kylechong7/Project-Lux/README.md

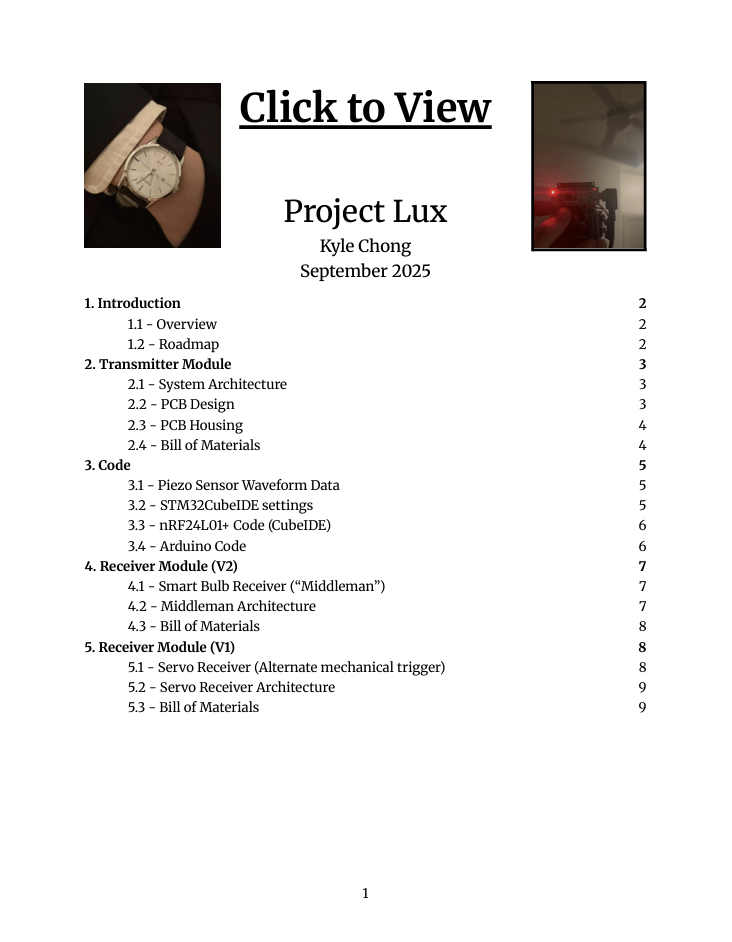
[picture p1: A_Overview/Click-to-view.png]
Open my site
