kylechong7/Project-Lux/A_Overview/cover-only.png

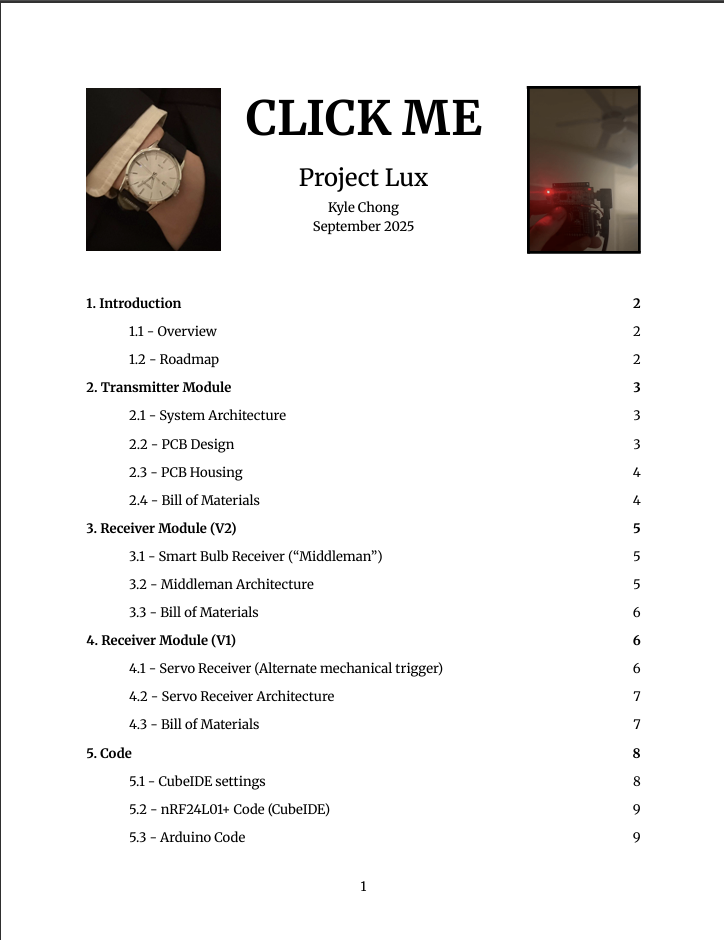
A_Overview/cover-only.png
