kylechong7/Project-Lux/PCB/CSV/bom.csv

Reference | Qty | Value | DNP | Exclude from BOM | Exclude from Board | Footprint | Datasheet
1k1,1M1,10k1 | 3 | R |  |  |  | Resistor_SMD:R_0603_1608Metric | ~
1uF1,100nF1,100nF2,100pF1 | 4 | C |  |  |  | Capacitor_SMD:C_0603_1608Metric | ~
4.7uF1 | 1 | C |  |  |  | Capacitor_SMD:C_0805_2012Metric | ~
D1 | 1 | LED |  |  |  | LED_SMD:LED_0603_1608Metric | ~
J3 | 1 | Piezo_Conn_Pin |  |  |  | Connector_Wire:SolderWire-0.15sqmm_1x04_P4mm_D0.5mm_OD1.5mm_Relief | ~
J4 | 1 | TC2070_-_Labelled |  | Excluded from BOM |  | TC2070:CONNECTOR_V1 | https://www.tag-connect.com/wp-content/uploads/bsk-pdf-manager/TC2070-IDC-NL_Datasheet_12.pdf
U1 | 1 | STM32G031K6Tx |  |  |  | Package_QFP:LQFP-32_7x7mm_P0.8mm | https://www.st.com/resource/en/datasheet/stm32g031k6.pdf
U3 | 1 | E01-ML01S |  |  |  | PCBLIB_E01-ML01S_2025-07-08:E01-ML01S
