kylechong7/Project-Lux/PCB/KiCad/Watch_PCB.kicad_pcb

## KiCad design PCB/KiCad/Watch_PCB.kicad_pcb (2025-10-12)

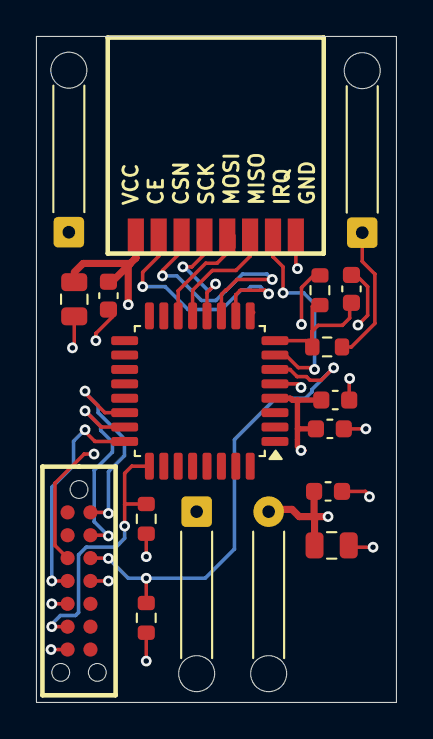
[picture p23: board Watch_PCB.kicad_pcb from above]

Board: 4 copper layers, 20.0 x 37.0 mm, 17 parts (0 on the bottom side), 14 nets.

Parts:
1M1, 10k1, 10k2, 10k3: R; R_0603_1608Metric
1uF1, 4.7nF1, 100nF1, 100nF2, 100nF3: C; C_0603_1608Metric
4.7uF1, 22uF1: C; C_0805_2012Metric
J1: Conn_01x02_Pin; SolderWire-0.15sqmm_1x02_P4mm_D0.5mm_OD1.5mm_Relief
J2, J3: Conn_01x01_Pin; SolderWire-0.15sqmm_1x01_D0.5mm_OD1.5mm_Relief
J4: TC2070_-_Labelled; CONNECTOR_V1
U1: STM32G031K6Tx; LQFP-32_7x7mm_P0.8mm
U3: E01-ML01S

Connections:
+3.3V: 1uF1.2, 4.7uF1.2, 10k2.1, 22uF1.2, 100nF1.2, 100nF2.1, 100nF3.1, J1.2, J4.3 (T_VCC), U1.4 (VDD), U3.1 (VCC)
GND: 1M1.2, 1uF1.1, 4.7nF1.2, 4.7uF1.1, 10k3.1, 10k3.2, 22uF1.1, 100nF1.1, 100nF2.2, 100nF3.2, J1.1, J3.1, J4.5 (GND), J4.6 (T_JTDO/T_SWO), J4.7 (GND), J4.11 (GNDDETECT), U1.5 (VSS), U1.25 (PA14), U3.8 (GND)
unnamed: 10k1.1, J2.1
unnamed: 10k2.2, J4.12 (T_NRST), U1.6 (PF2)
unnamed: J4.13 (T_VCP_RX), U1.23 (PA10/PA12)
unnamed: J4.14 (T_VCP_TX), U1.22 (PA9/PA11)
unnamed: U1.7 (PA0), U3.7 (IRQ)
unnamed: 1M1.1, 4.7nF1.1, 10k1.2, U1.8 (PA1)
unnamed: U1.10 (PA3), U3.2 (CE)
unnamed: U1.11 (PA4), U3.3 (CSN)
unnamed: U1.12 (PA5), U3.4 (SCK)
unnamed: U1.13 (PA6), U3.6 (MISO)
unnamed: U1.14 (PA7), U3.5 (MOSI)
unnamed: J4.4, U1.24 (PA13)
