kylechong7/Project-Lux/Code/STM32CubeIDE/main_rx.c

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
/* Includes ------------------------------------------------------------------*/
#include "main.h"
#include "lptim.h"
#include "spi.h"
#include "usart.h"
#include "gpio.h"
#include "tim.h"   // <- needed on RX for TIM1 handle & init
/* USER CODE BEGIN Includes */
#include "nrf_drivers.h"
/* USER CODE END Includes */

/* USER CODE BEGIN PD */
#define RX_QUIET_MS 150u
static uint32_t rx_quiet_until = 0;
/* USER CODE END PD */


void SystemClock_Config(void);
/* USER CODE BEGIN 0 */
uint64_t RxpipeAddrs = 0x11223344AAULL;
char myRxData[50];
char myAckPayload[32] = "Ack by STMF7!";

extern TIM_HandleTypeDef htim1;
#define SERVO_TIM       (&htim1)
#define SERVO_CH        TIM_CHANNEL_4

// 50 Hz frame
#define SERVO_PERIOD_US 20000U
// Your stated end-stops
#define SERVO_MIN_US    500U
#define SERVO_MAX_US    2500U

static bool servo_is_pos90 = false;

static inline void Servo_WritePulseUS(uint16_t us)
{
    if (us < SERVO_MIN_US) us = SERVO_MIN_US;
    if (us > SERVO_MAX_US) us = SERVO_MAX_US;

    // We assume ARR is 20000-1 and PSC makes 1 tick = 1 µs.
    __HAL_TIM_SET_COMPARE(SERVO_TIM, SERVO_CH, us);
}

void Servo_Init(void)
{
    // Start PWM output
    HAL_TIM_PWM_Start(SERVO_TIM, SERVO_CH);

    // Safe neutral on boot (optional)
    Servo_WritePulseUS(1500);
    servo_is_pos90 = false;
}

void Servo_GotoNeg90(void) { servo_is_pos90 = false; Servo_WritePulseUS(500);  }
void Servo_GotoPos90(void) { servo_is_pos90 = true;  Servo_WritePulseUS(2500); }

void Servo_Toggle(void)
{
    if (servo_is_pos90) Servo_GotoNeg90();
    else                Servo_GotoPos90();
}
/* USER CODE END 0 */

/**
  * @brief  The application entry point.
  * @retval int
  */
int main(void)
{

  /* MCU Configuration--------------------------------------------------------*/

  /* Reset of all peripherals, Initializes the Flash interface and the Systick. */
  HAL_Init();

  /* Configure the system clock */
  SystemClock_Config();

  /* Initialize all configured peripherals */
  MX_GPIO_Init();
  MX_LPTIM1_Init();
  MX_SPI1_Init();
  MX_USART2_UART_Init();
  /* USER CODE BEGIN 2 */
  	NRF24_begin(GPIOA, NRF_CSN_Pin, NRF_CE_Pin, hspi1);
  	nrf24_DebugUART_Init(huart2);

  	GPIO_InitTypeDef gi_ce = {0};
  	gi_ce.Pin = NRF_CE_Pin;
  	gi_ce.Mode = GPIO_MODE_OUTPUT_PP;
  	gi_ce.Pull = GPIO_NOPULL;
  	gi_ce.Speed = GPIO_SPEED_FREQ_HIGH;
  	HAL_GPIO_Init(NRF_CE_GPIO_Port, &gi_ce);

  	NRF24_disableDynamicPayloads();
  	NRF24_setAutoAck(true);

    uint8_t enaa = NRF24_read_register(REG_EN_AA);

  	NRF24_setRetries(10,15);
  	NRF24_setDataRate(RF24_250KBPS);
  	NRF24_setChannel(76);
  	NRF24_setPayloadSize(32);
  	NRF24_openWritingPipe(0x11223344AAULL);      // TX
  	NRF24_openReadingPipe(0, 0x11223344AAULL);   // RX

  	// Power-up + force PRX
  	uint8_t cfg = NRF24_read_register(REG_CONFIG);
  	cfg |= _BV(BIT_PWR_UP) | _BV(BIT_PRIM_RX);
  	NRF24_write_register(REG_CONFIG, cfg);
  	HAL_Delay(5);
  	// Make absolutely sure CE is high in RX
  	HAL_GPIO_WritePin(NRF_CE_GPIO_Port, NRF_CE_Pin, GPIO_PIN_SET);

  	uint8_t after = NRF24_read_register(REG_CONFIG);
  	printf("CONFIG=0x%02X (expect bit0=1 for PRX)\r\n", after);

  	NRF24_flush_rx();                           // clean slate
  	NRF24_resetStatus();
  	NRF24_startListening();

  	printRadioSettings();
  	printStatusReg();
  	printConfigReg();
    MX_TIM1_Init();     // make sure Cube actually generated this
    Servo_Init();       // calls HAL_TIM_PWM_Start + sets neutral

  /* USER CODE END 2 */


  /* Infinite loop */
  /* USER CODE BEGIN WHILE */
  while (1)
  {
    /* USER CODE END WHILE */
	  if (NRF24_available()) {
	      bool got_any = false;
	      while (!(NRF24_read_register(REG_FIFO_STATUS) & _BV(BIT_RX_EMPTY))) {
	          NRF24_read((uint8_t*)myRxData, 32);
	          got_any = true;
	      }
	      if (got_any) {
	          uint32_t now = HAL_GetTick();
	          if (now >= rx_quiet_until) {
	        	    HAL_GPIO_TogglePin(LED_OUT_GPIO_Port, LED_OUT_Pin);
	        	    Servo_Toggle();
	              rx_quiet_until = now + RX_QUIET_MS;
	          }
	      }
	  }
    /* USER CODE BEGIN 3 */
  }
  /* USER CODE END 3 */
}

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
