kylechong7/Project-Lux/(commit log)

2025-09-22 Create gerbers
2025-09-25 Create .stl files
2025-09-25 Create PCB Housing
2025-10-13 Create ArduinoIDE
