kylechong7/Project-Lux/(notices)

Notices in the files:
Code/STM32CubeIDE/main_rx.c:
Copyright (c) 2025 STMicroelectronics.
All rights reserved.
This software is licensed under terms that can be found in the LICENSE file
